petegaggs/MIDI-controlled-oscillator/oscillator.jpg

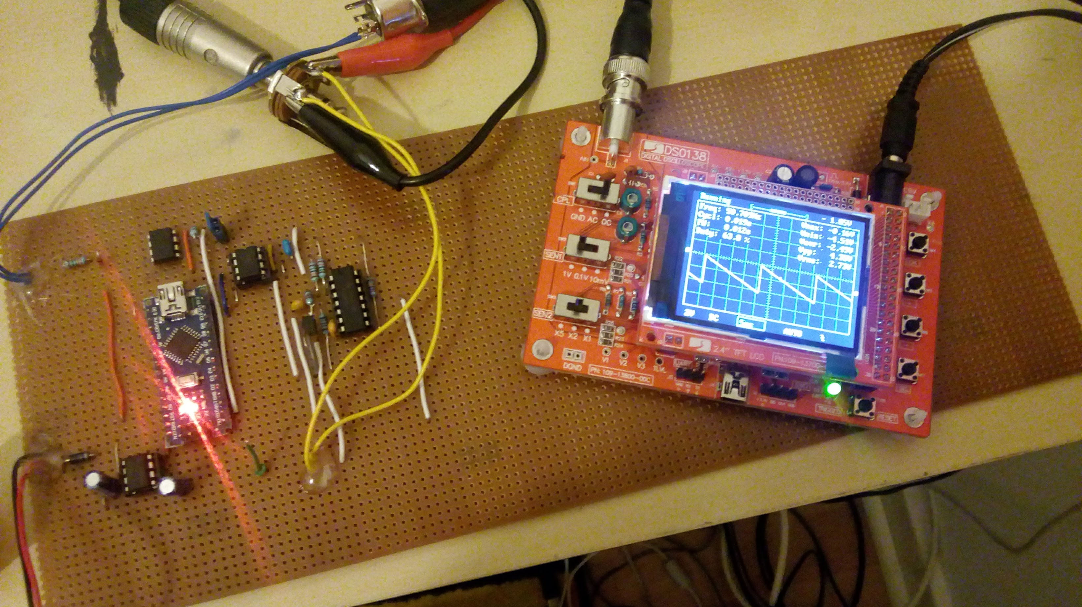
oscillator.jpg
