petegaggs/MIDI-controlled-oscillator/oscillator design notes.xlsx

Sheet: oscillator
design calculations for arduino controlled oscillator
by Peter Gaggs
https://github.com/petegaggs/MIDI-controlled-oscillator
clk_io | 16000000
frequency of highest note | 4186
frequency of lowest note | 27.5
period of highest note in microseconds | 238.8915432
period of lowest note in microseconds | 36363.63636
highest note in clk_io cycles | 3822.264692
lowest note in clk_io cycles | 581818.1818
 |  | hex
half period of highest note in clk_io cycles | 1911.132346 | 777
half period of lowest note in clk_io cycles | 290909.0909 | 4705D
Pre-scaling | 8
timer clk | 2000000
 |  | hex
half period of highest note in clk_t cycles | 238.8915432 | EE
half period of lowest note in clk_t cycles | 36363.63636 | 8E0B
 |  | hex
period of highest note in clk_t cycles | 477.7830865 | 1DD
period of lowest note in clk_t cycles | 72727.27273 | 11C17
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
