petegaggs/MIDI-controlled-oscillator/arduino_DCO_mk2.pdf

+5V

+9V

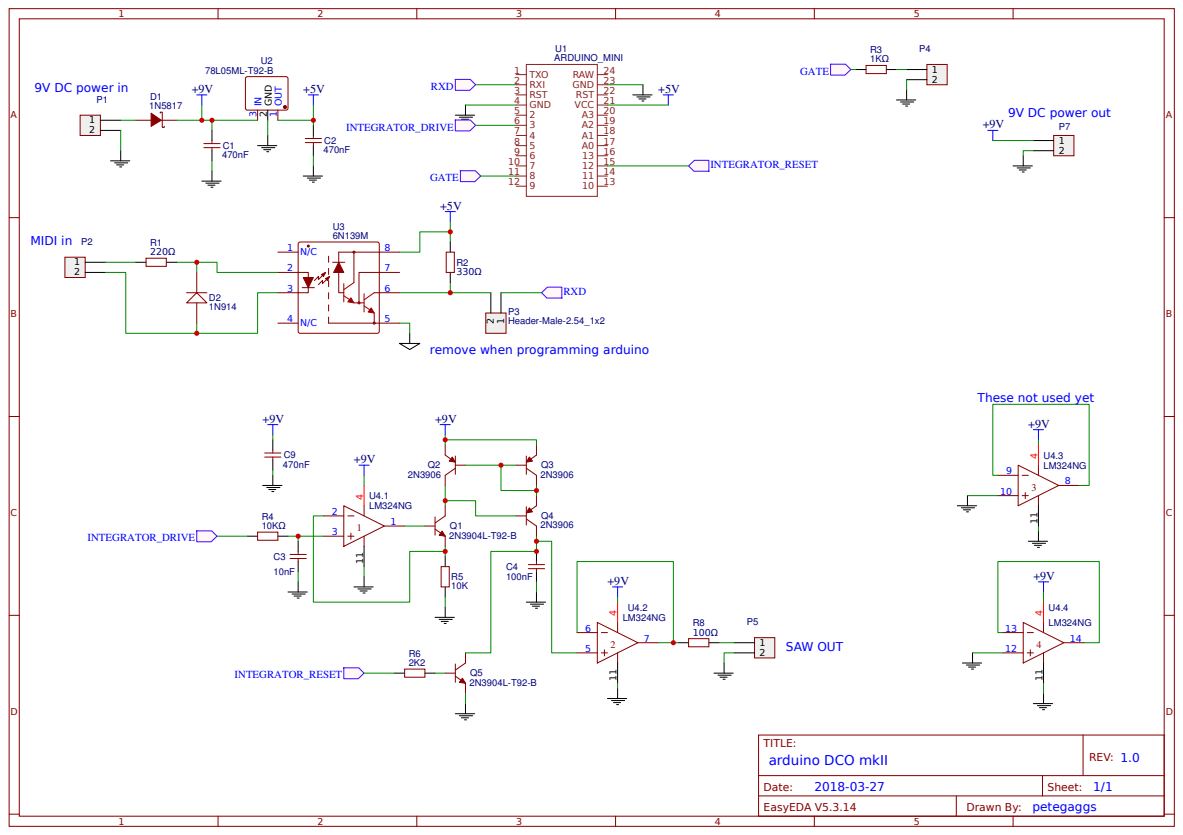
[picture p2: page 1]

remove when programming arduino

These not used yet
