petegaggs/MIDI-controlled-oscillator/MIDI-controlled-oscillator.pdf

### POWER 9V DC

+9V

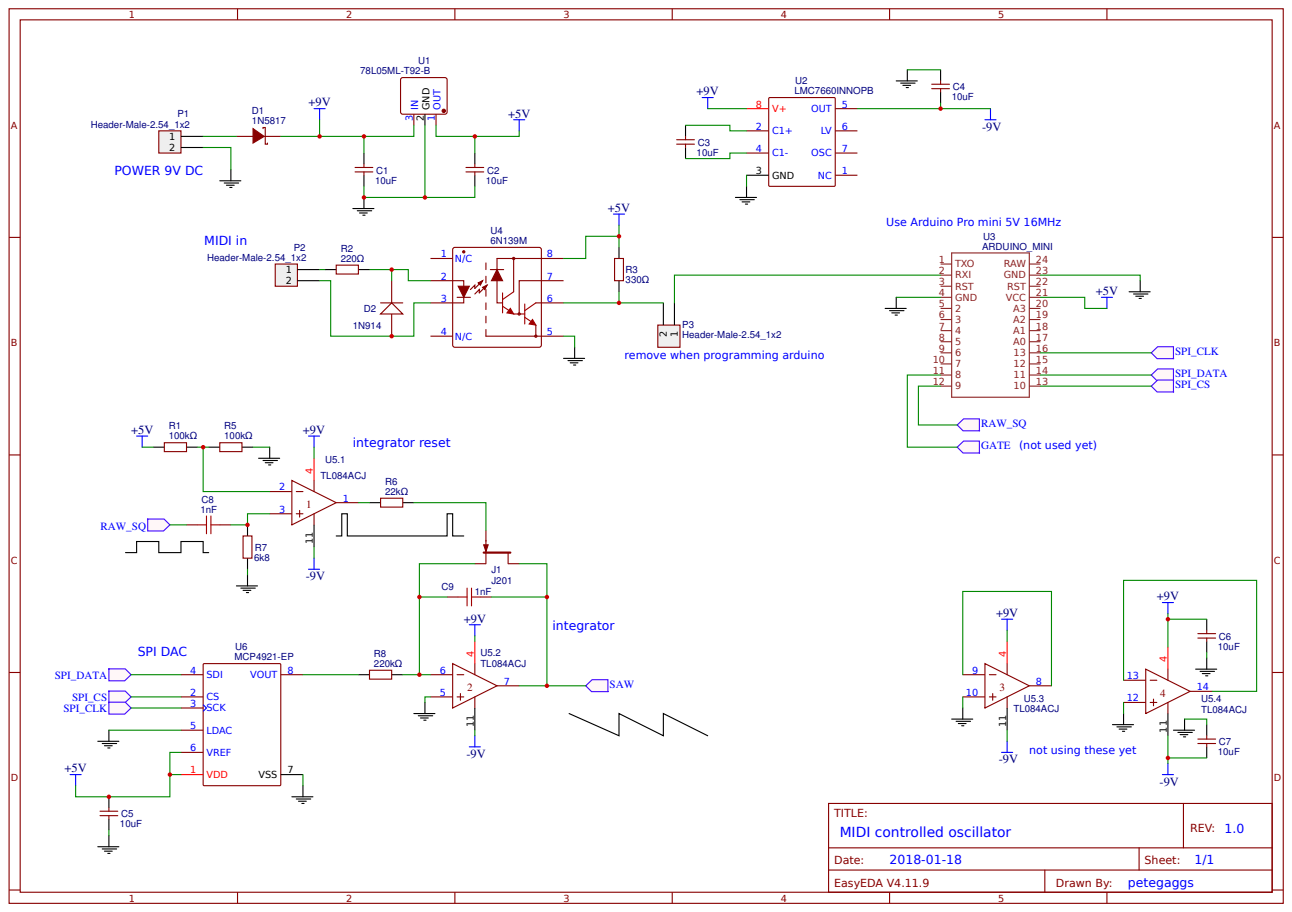
[picture p3: page 1]

Use Arduino Pro mini 5V 16MHz

remove when programming arduino

RAW_SQ
GATE (not used yet)

not using these yet
