petegaggs/MIDI-controlled-oscillator/(commit log)

2018-02-14 Add files via upload
    This update replaces the lookup tables with a calculation done on the fly. Also added MIDI pitchbend support
    [synth_controller.ino]
2018-02-15 Add files via upload
    Added optional analogue control, to modulate pitch, on pin A0.
2018-04-02 Add files via upload
    MK2 hardware is an attempt to make it a bit simpler/cheaper.
    Uses 8 bit PWM instead of SPI DAC to drive the integrator. However, note that the range is not as large, Top midi note is now 84 (c-6). Note above this will play, but the amplitude will fall.
    Also, integrator is a different design, does not need a negative supply rail.
    software supports both versions of hardware, use the #define MK1hHW or MK2HW as appropriate
2018-04-17 Add files via upload
    added noise output pin, and sub oscillator output (square wave one octave below main oscillator)
    [synth_controller.ino]
2021-05-23 Add files via upload
    This is the cut down version
2021-05-28 Add files via upload
    fix the mk3 code
    [arduino_DCO_mk3.ino]
